ericalapiestral-hash/A1/archive/README.md

# 이전 구성의 참고 코드

A_board_temp_test는 수온 센서를 포함했던 이전 구성의 진단 코드입니다. 현재 기본 A/B 펌웨어와 앱에서는 수온 센서를 사용하지 않습니다. 이 코드를 현재 보드에 업로드하는 안내는 아닙니다.
