ericalapiestral-hash/A1/docs/A_board_fritzing.png

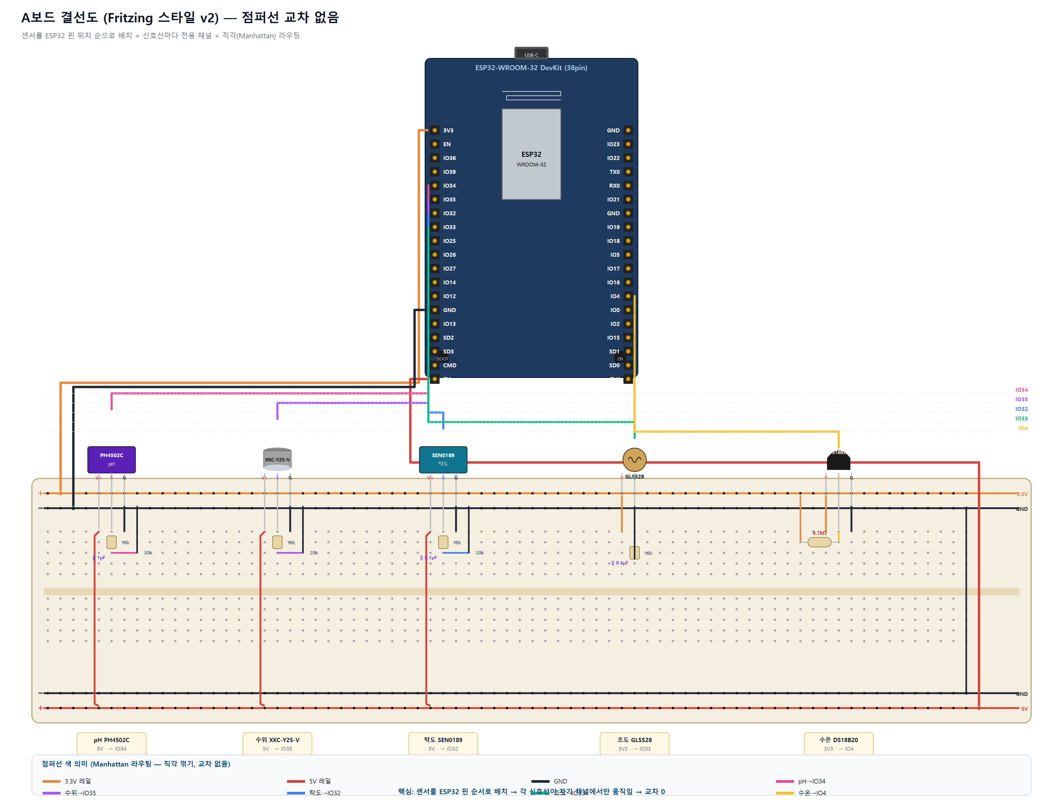
docs/A_board_fritzing.png
