ericalapiestral-hash/A1/docs/app_mockup.png

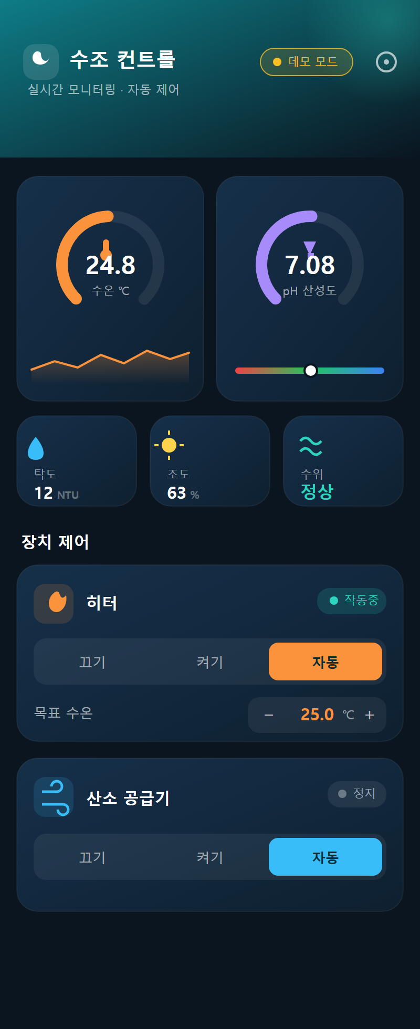
docs/app_mockup.png
