ericalapiestral-hash/A1/docs/B_board_fritzing.png

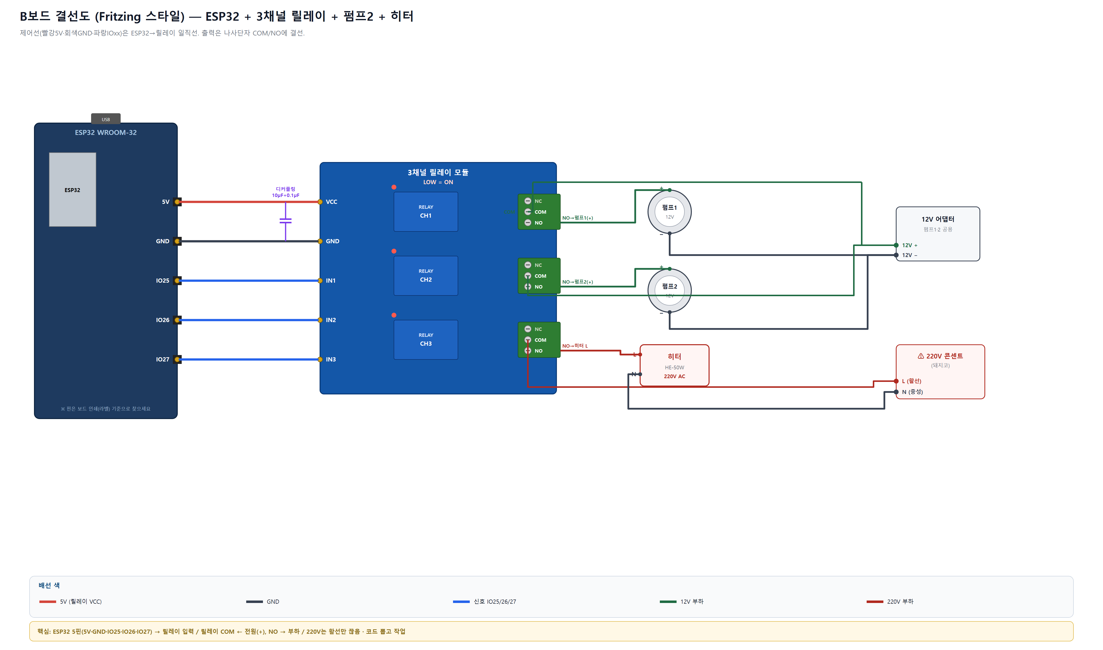
docs/B_board_fritzing.png
