ericalapiestral-hash/A1/docs/explainer_2026-10-15/images/01_system_overview.png

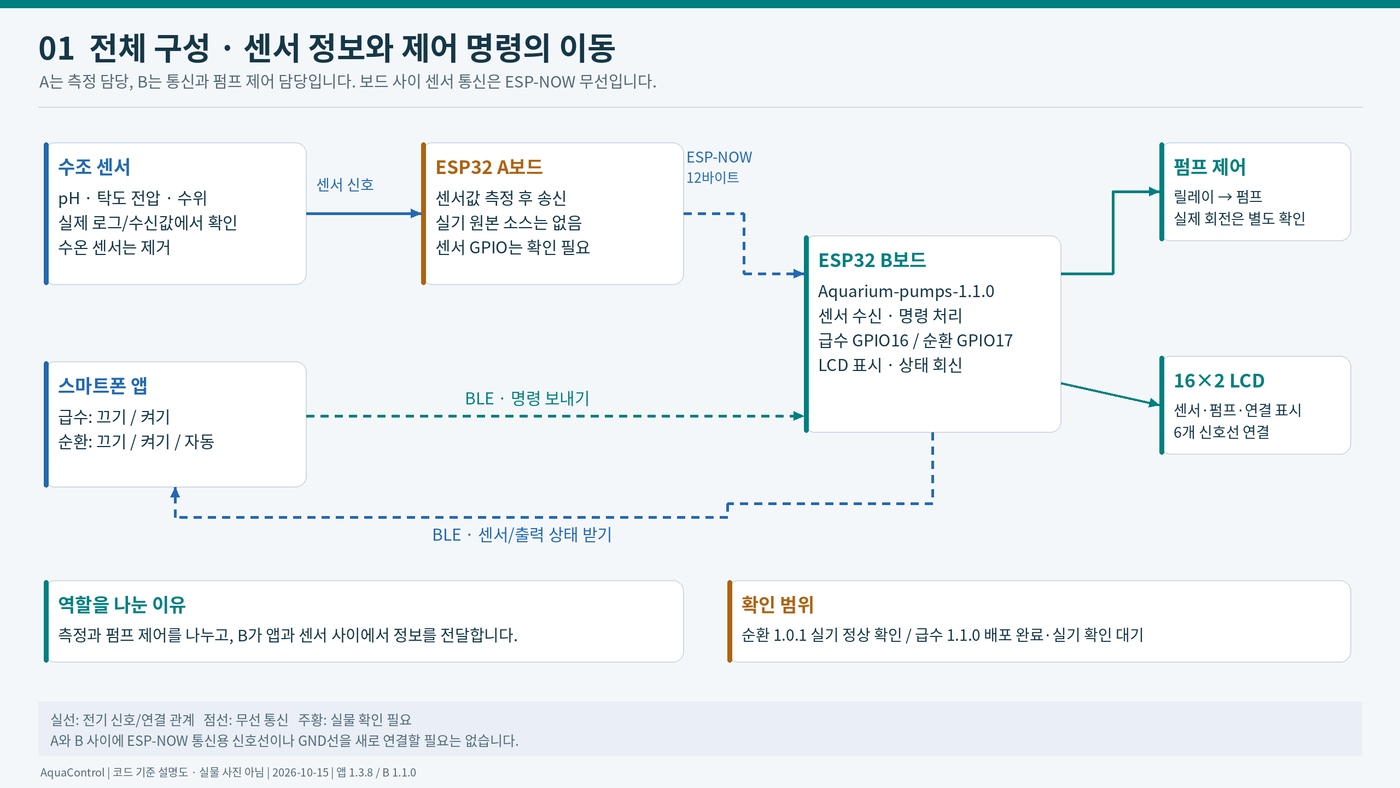
docs/explainer_2026-10-15/images/01_system_overview.png
