ericalapiestral-hash/A1/docs/explainer_2026-10-15/images/02_current_sensors.png

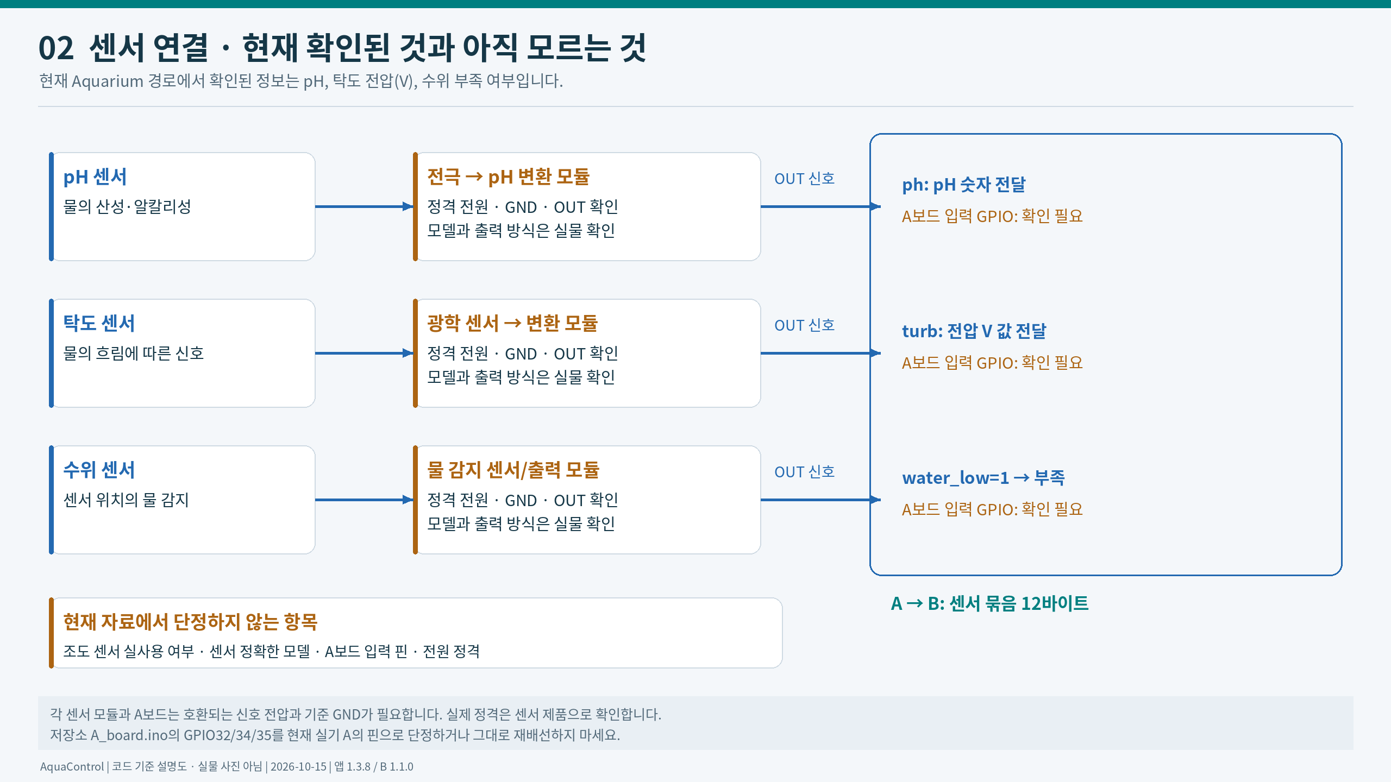
docs/explainer_2026-10-15/images/02_current_sensors.png
