ericalapiestral-hash/A1/docs/explainer_2026-10-15/images/03_b_board_connections.png

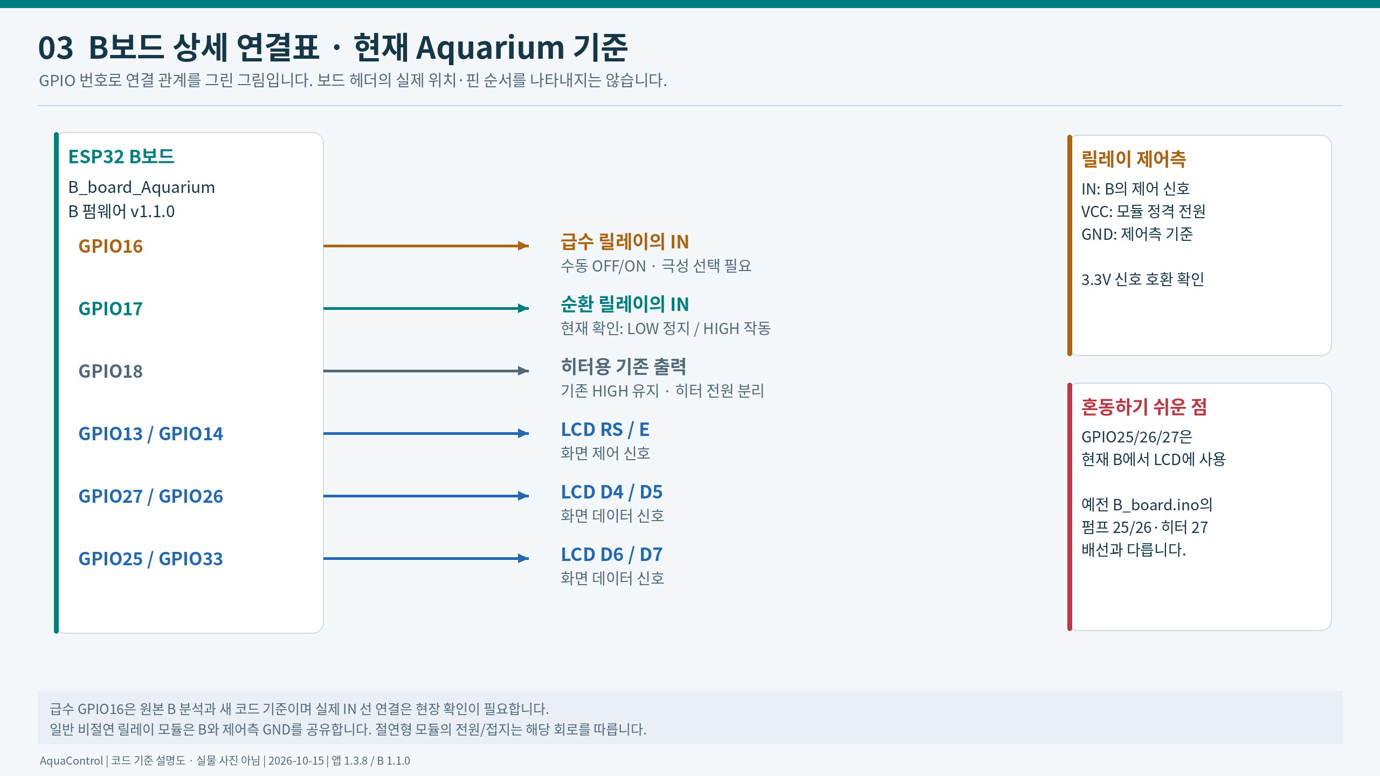
docs/explainer_2026-10-15/images/03_b_board_connections.png
