ericalapiestral-hash/A1/docs/explainer_2026-10-15/images/05_relay_and_dc_pump.png

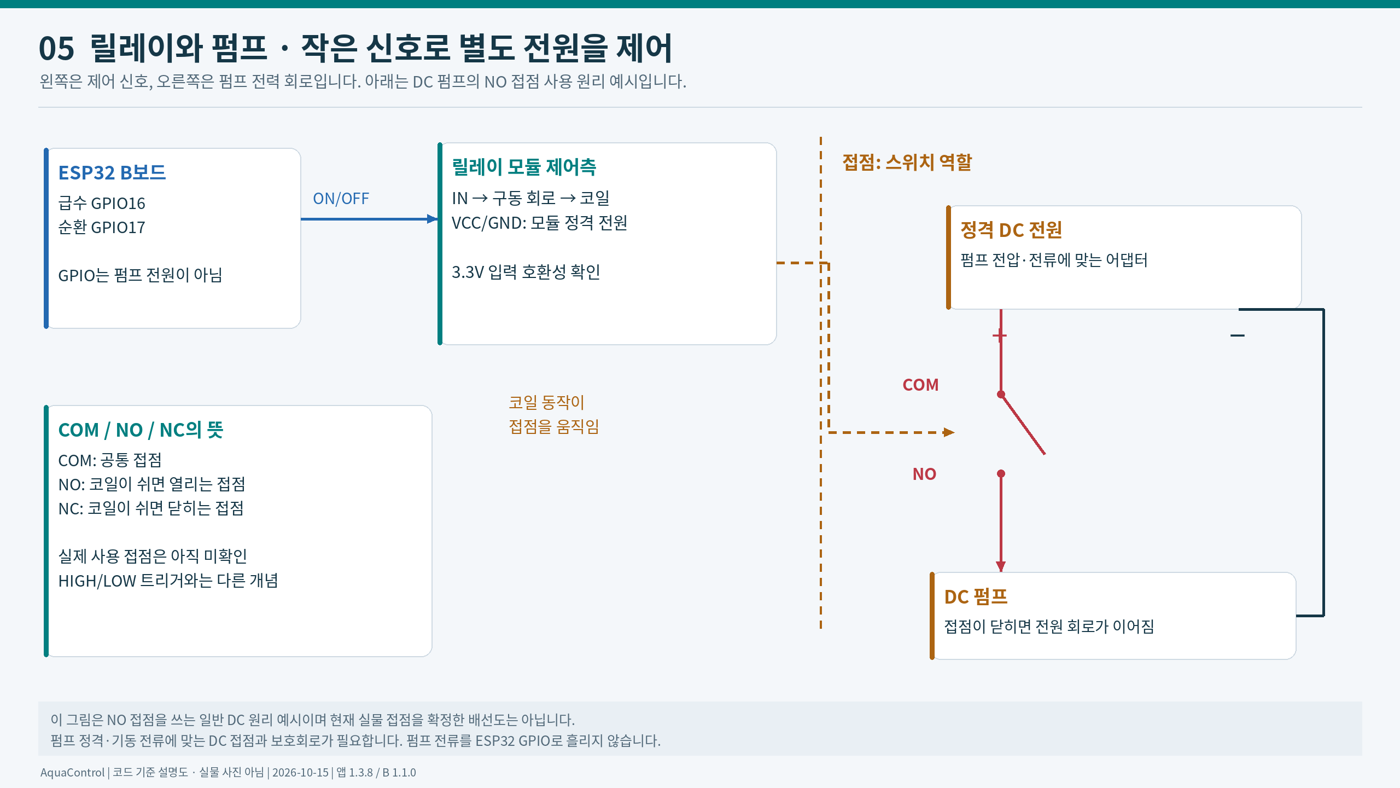
docs/explainer_2026-10-15/images/05_relay_and_dc_pump.png
