ericalapiestral-hash/A1/docs/explainer_2026-10-15/images/06_power_domains.png

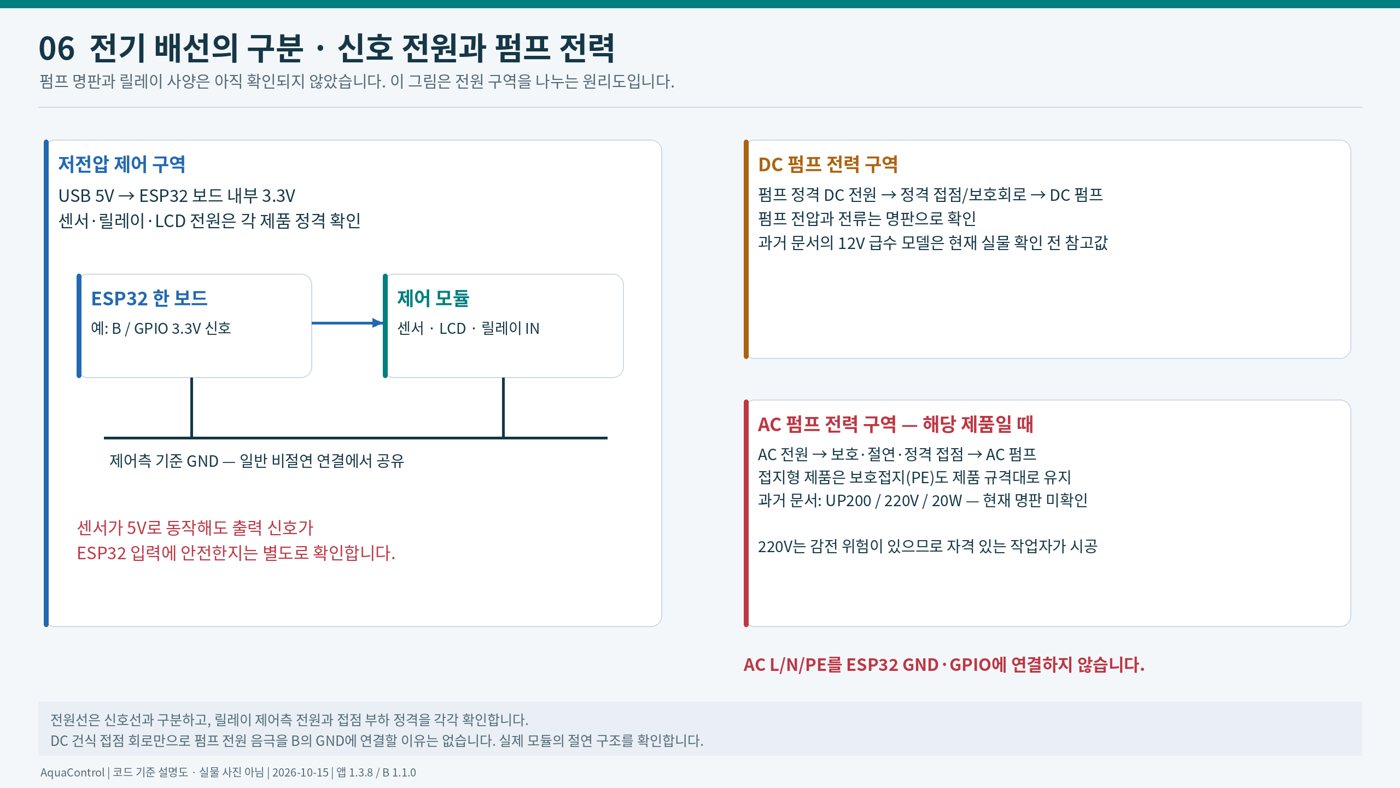
docs/explainer_2026-10-15/images/06_power_domains.png
