ericalapiestral-hash/A1/docs/explainer_2026-10-15/images/07_sensor_signal_principles.png

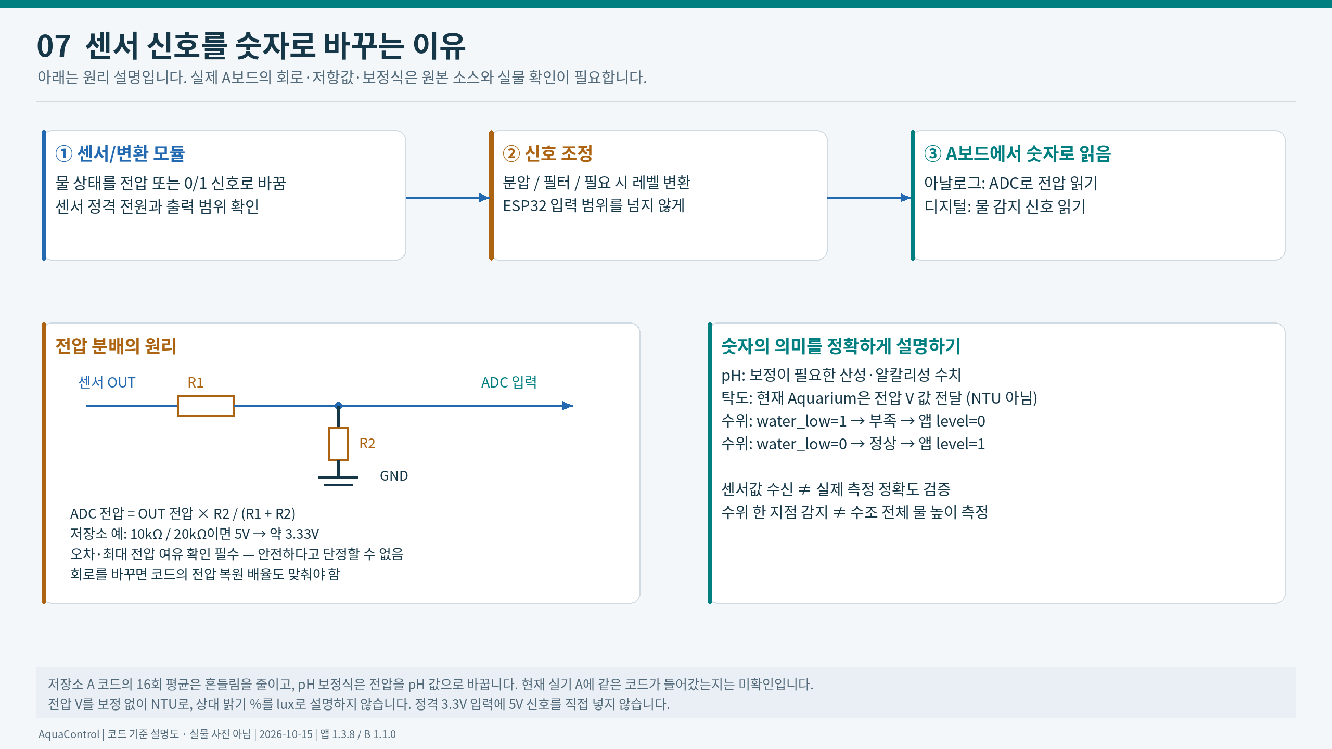
docs/explainer_2026-10-15/images/07_sensor_signal_principles.png
