ericalapiestral-hash/A1/docs/explainer_2026-10-15/images/08_control_and_timing.png

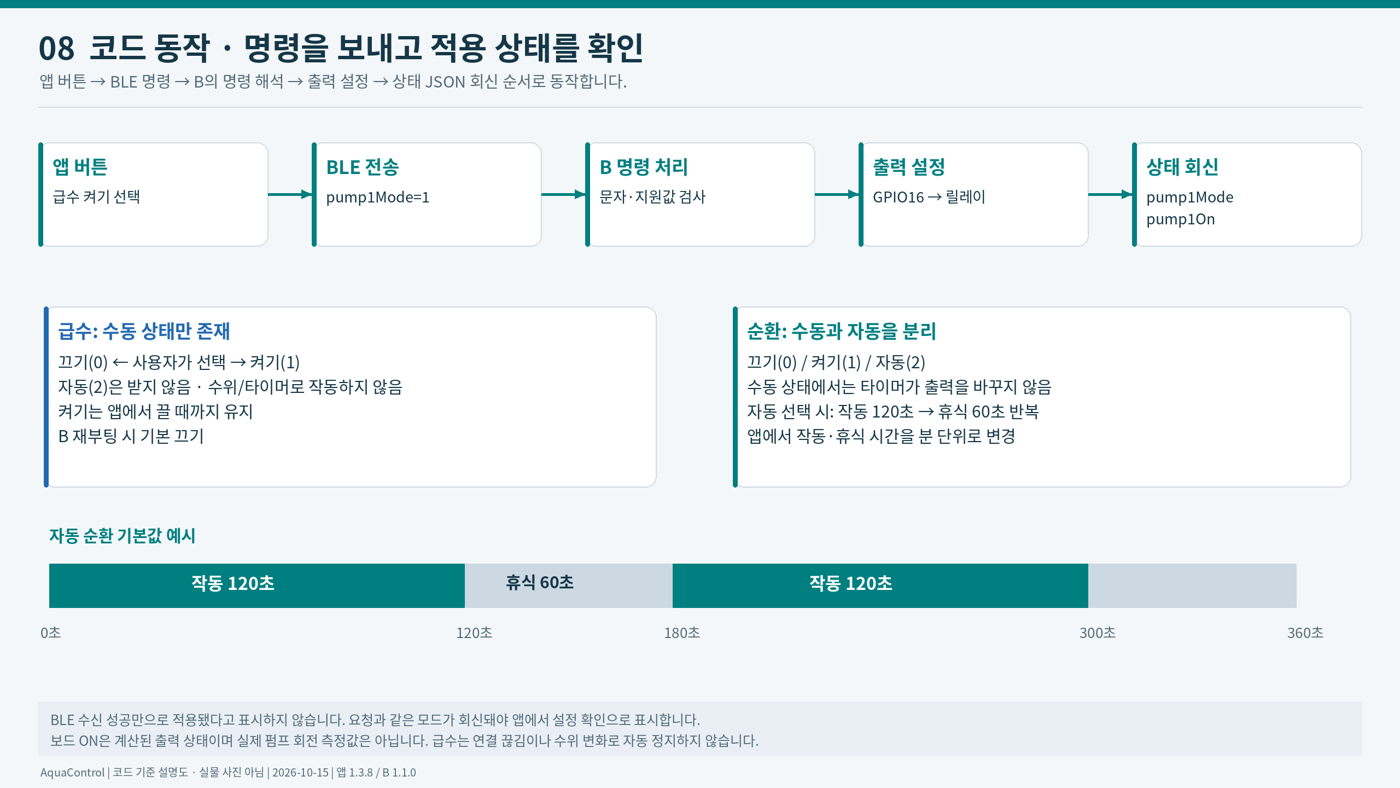
docs/explainer_2026-10-15/images/08_control_and_timing.png
