ericalapiestral-hash/A1/docs/A_board_wiring_v3.png

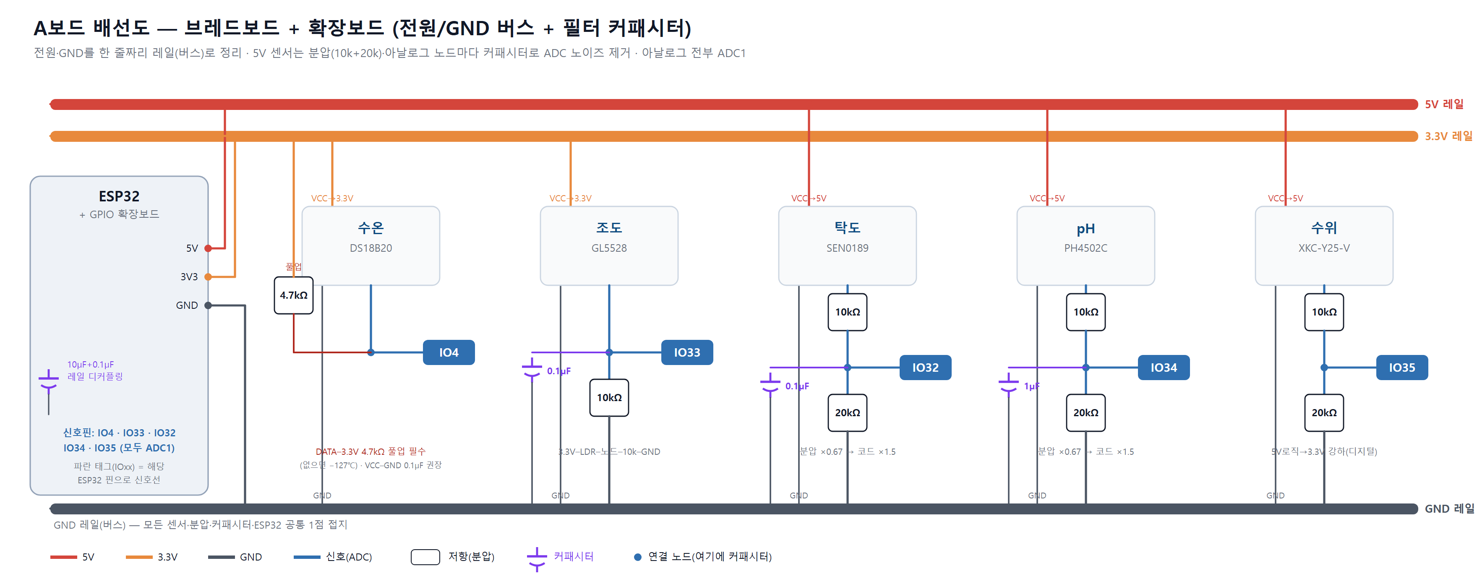
docs/A_board_wiring_v3.png
