ericalapiestral-hash/A1/docs/B_board_wiring_v3.png

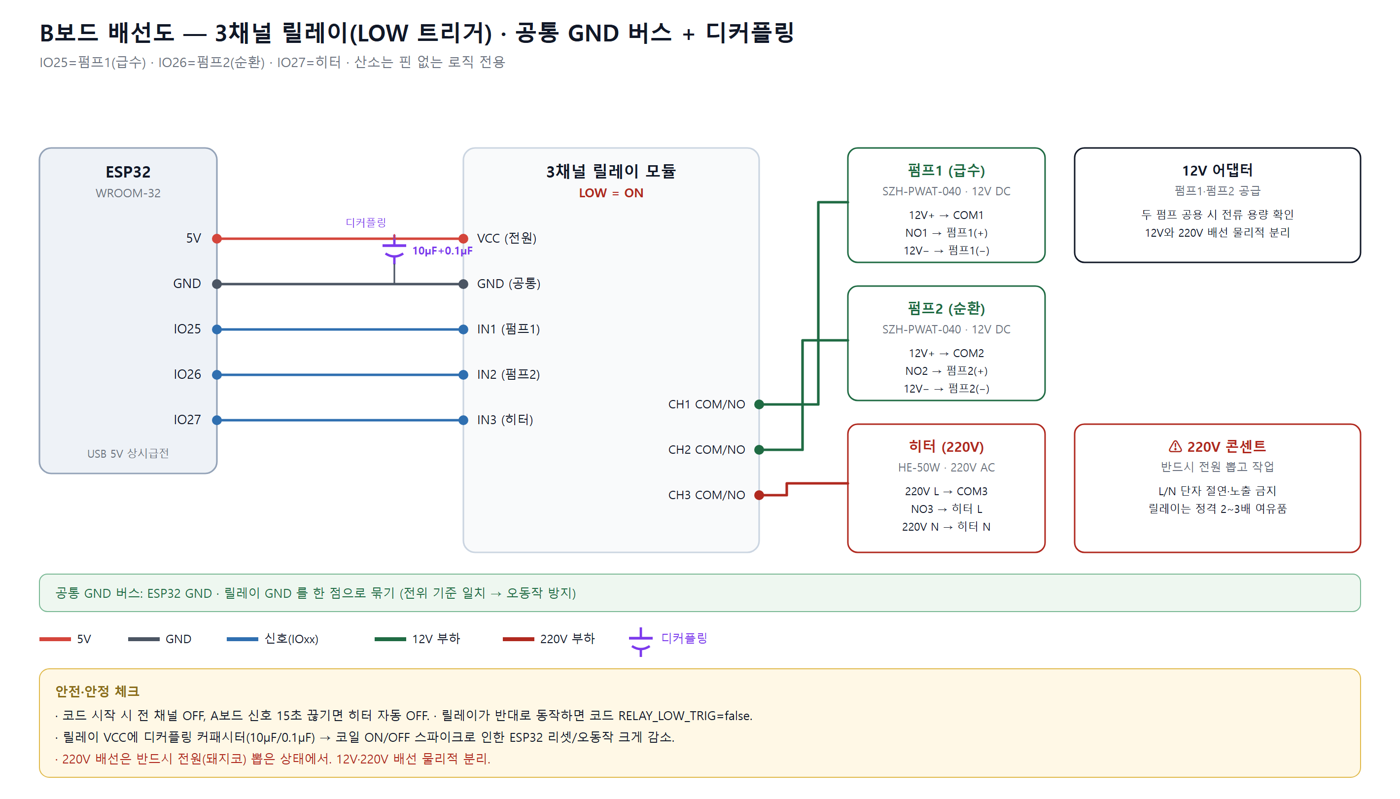
docs/B_board_wiring_v3.png
