ericalapiestral-hash/A1/docs/decoupling_cap_howto.png

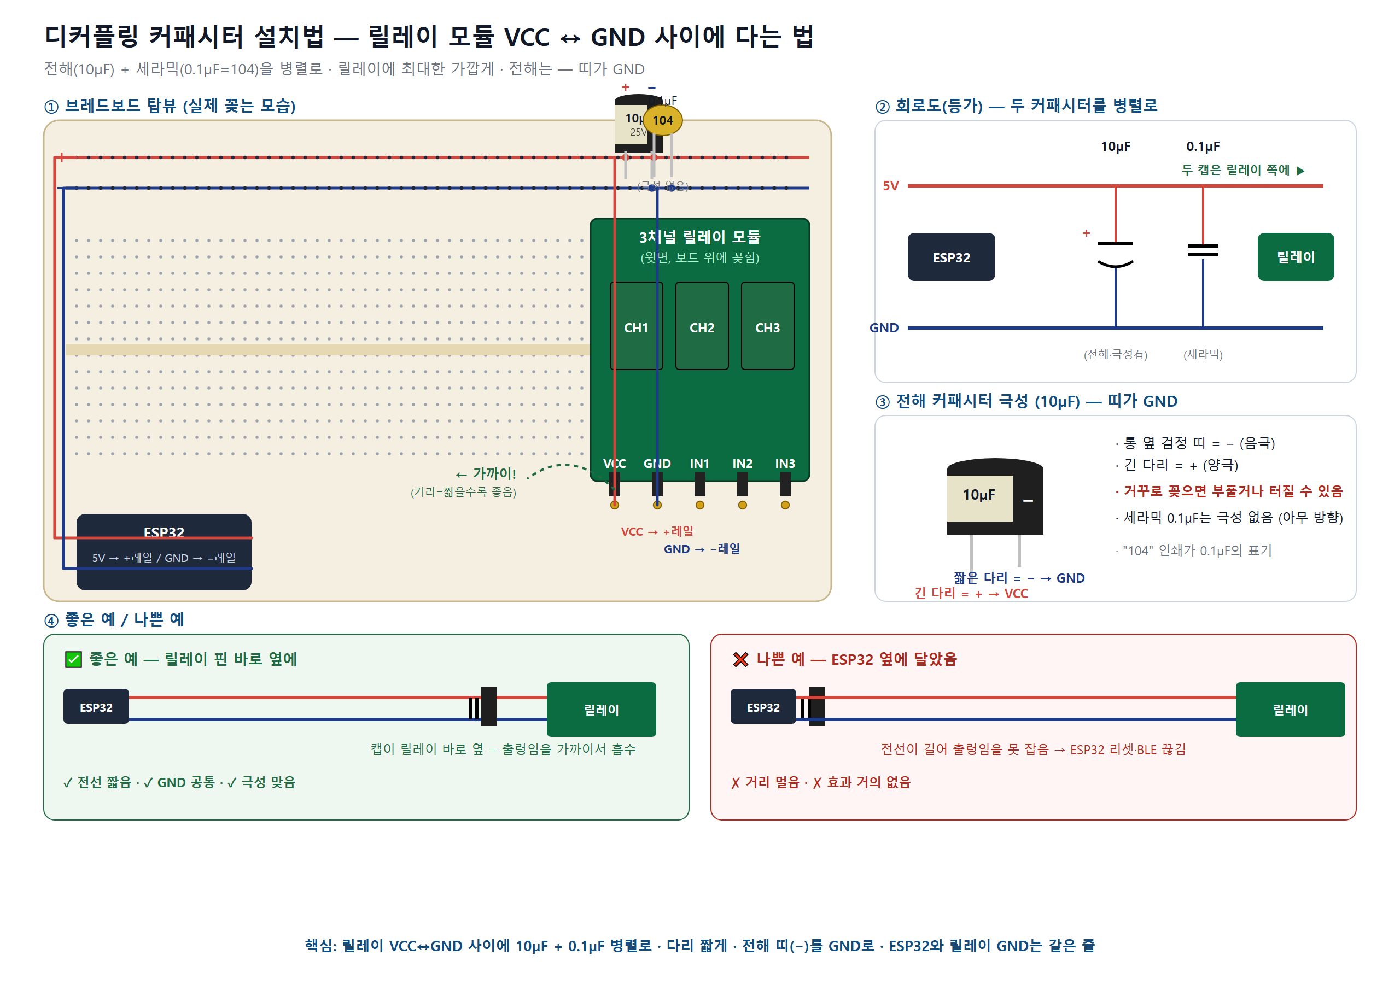
docs/decoupling_cap_howto.png
