ericalapiestral-hash/A1/docs/explainer_2026-10-15/images/04_lcd_wiring.png

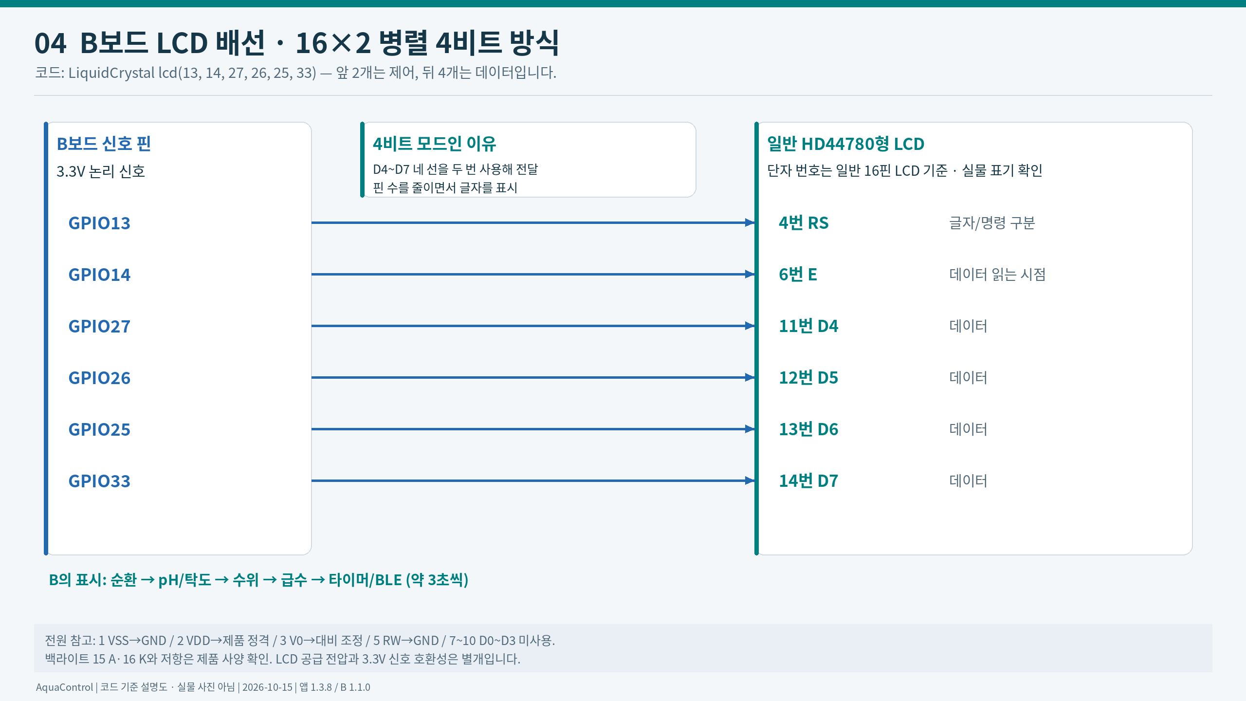
docs/explainer_2026-10-15/images/04_lcd_wiring.png
