ericalapiestral-hash/A1/docs/LCD_wiring.png

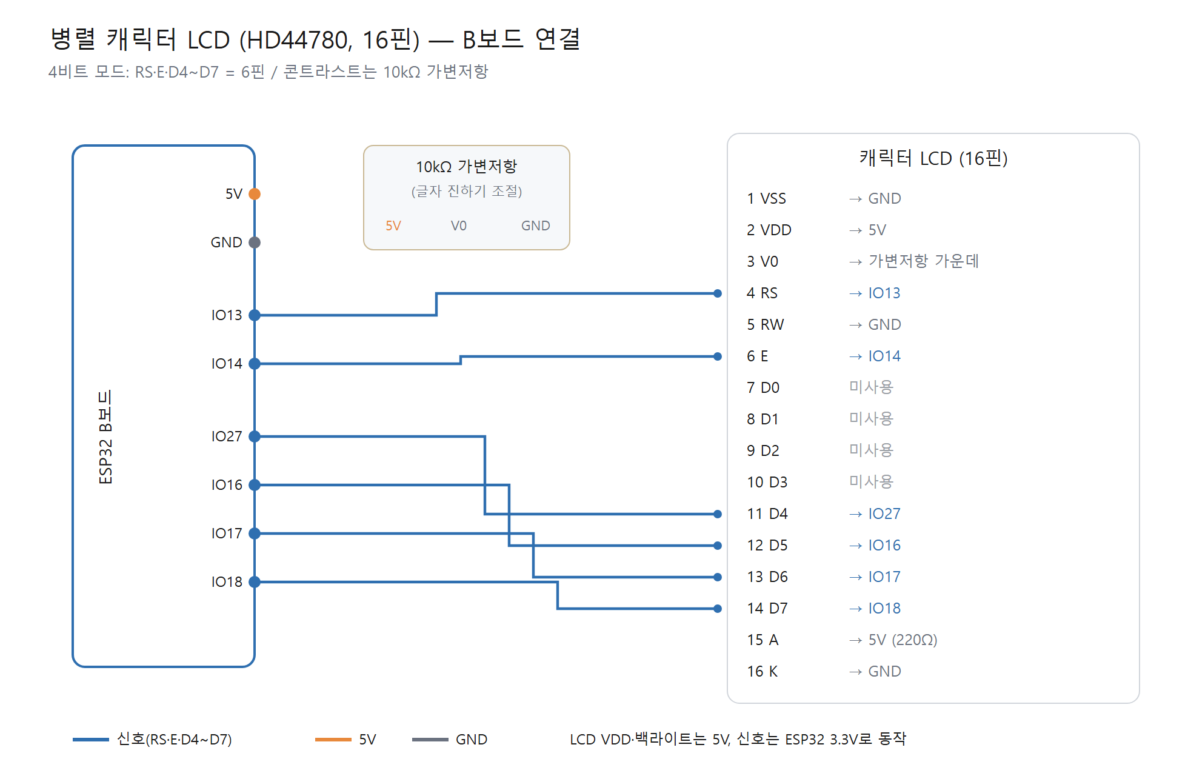
docs/LCD_wiring.png
