ericalapiestral-hash/A1/docs/pump_diode_howto.png

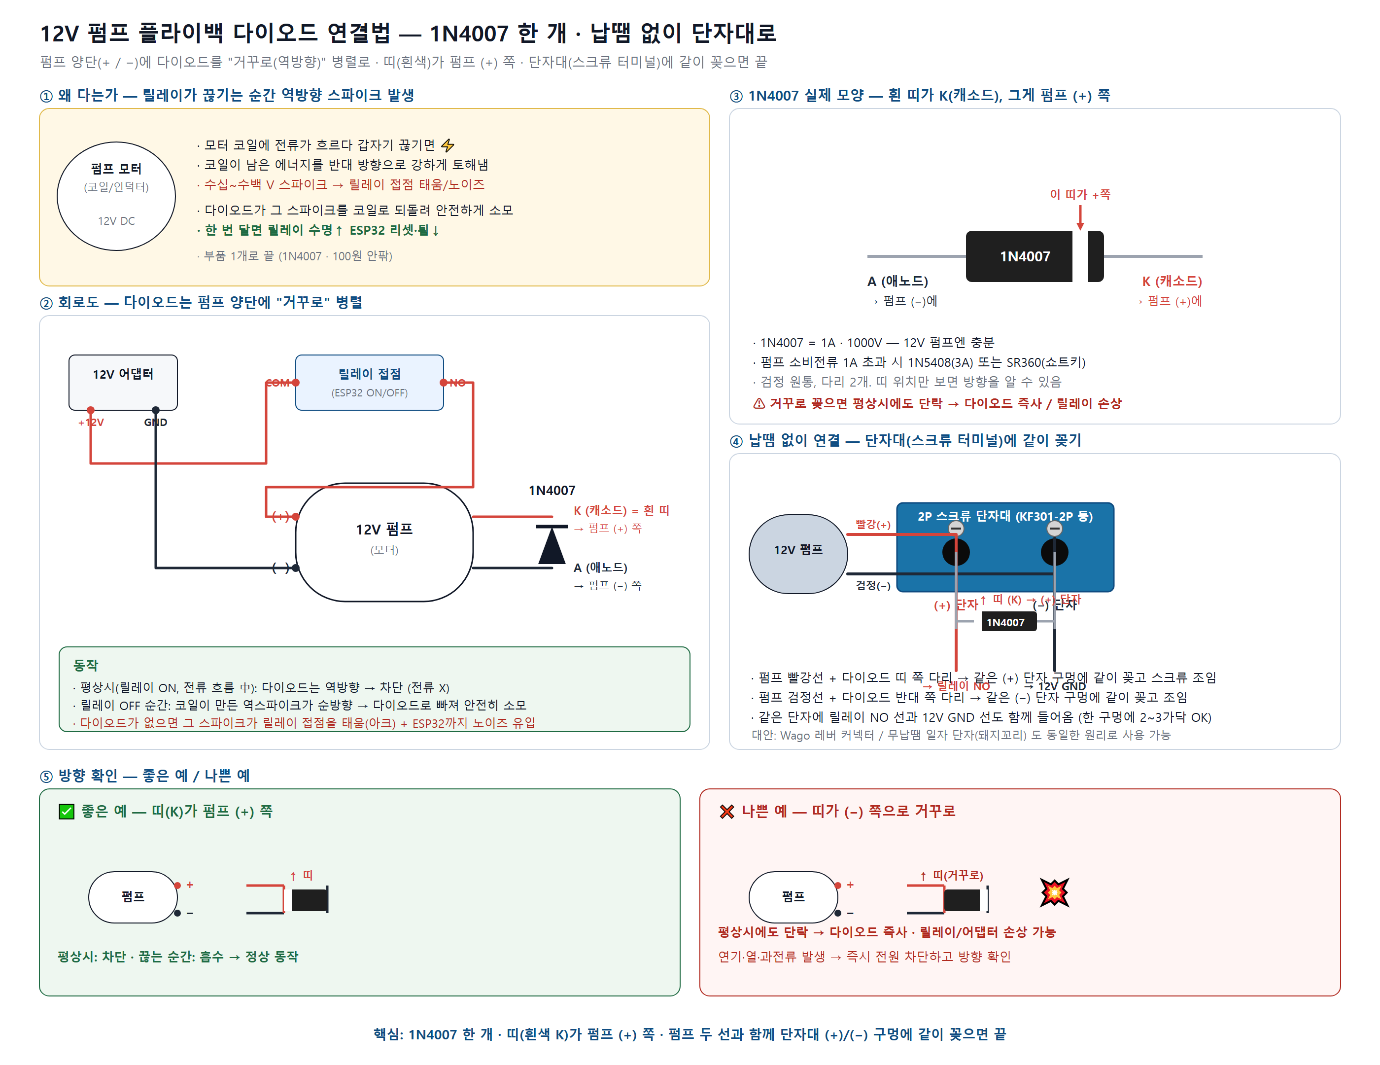
docs/pump_diode_howto.png
