ericalapiestral-hash/A1/docs/pump_wiring_12v_each.png

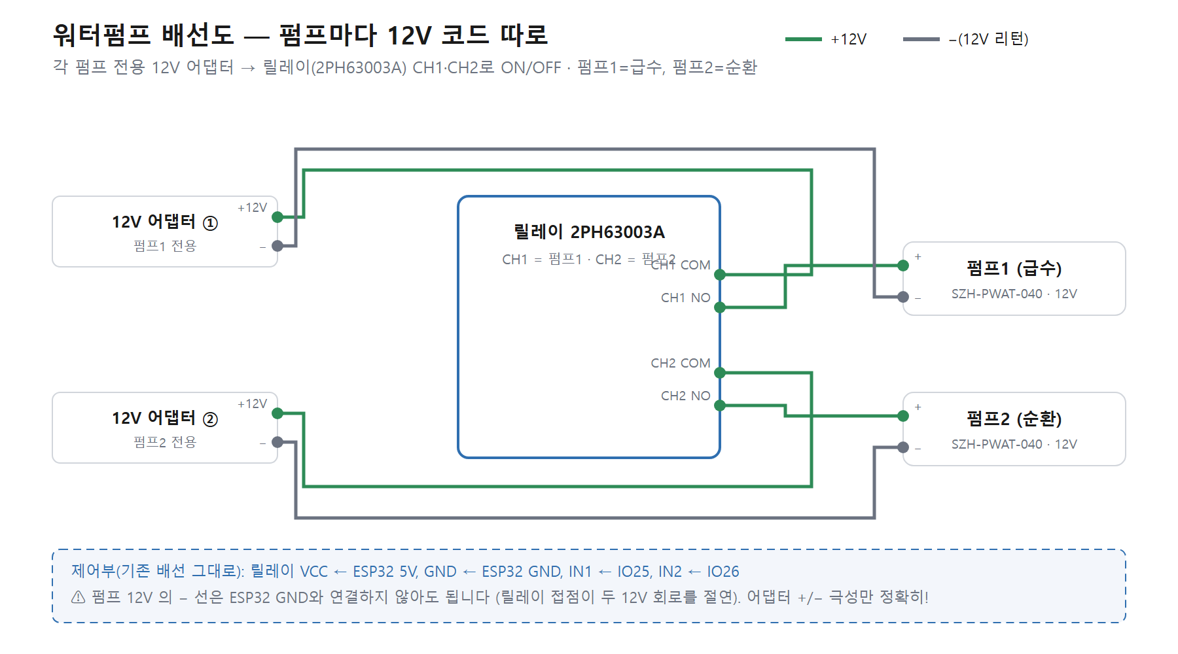
docs/pump_wiring_12v_each.png
