ericalapiestral-hash/A1/docs/UP200_circulation_wiring.png

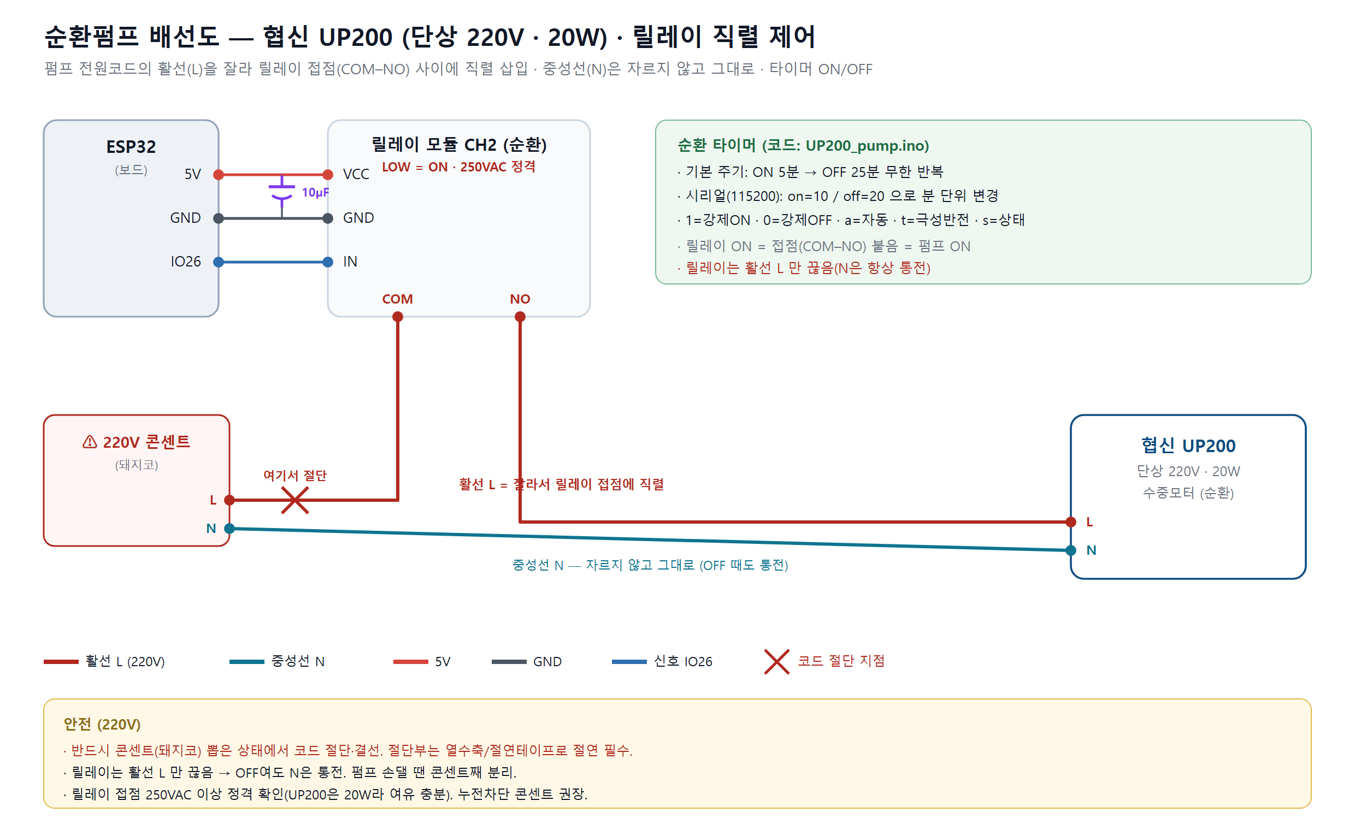
docs/UP200_circulation_wiring.png
