ericalapiestral-hash/A1/(commit log)

2026-08-24 초기 커밋: ESP32 수조 모니터링·제어 시스템
    A보드(센서+LCD) ─ESP-NOW─ B보드(릴레이 제어+BLE) ─BLE─ 안드로이드 앱.
    이번 작업으로 함께 반영한 내용:
    - A_board.ino 컴파일 오류 수정
    getTempCByIndex(0) 뒤에 붙어 있던 오타 'E' 제거.
    - 앱 자동 업데이트 기능 추가 (GitHub Releases)
    lib/updater.dart 릴리스 조회·버전 비교·APK 다운로드(진행률)·설치 실행
    lib/update_ui.dart 업데이트 안내 다이얼로그, 설치 권한 안내
    dashboard.dart 시작 시 자동 확인 + 설정 시트의 '업데이트 확인'
    MainActivity.kt 버전 조회/저장 경로/설치 권한/설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
    [12V_펌프2개_전체결선표.xlsx]
2026-08-24 업데이트 저장소를 ericalapiestral-hash/A1 로 설정
    lib/updater.dart 의 kGithubOwner/kGithubRepo 플레이스홀더를 실제 저장소로
    교체. 이제 앱이 해당 저장소의 Releases 에서 최신 버전을 확인한다.
2026-08-24 GitHub Actions 자동 배포 추가
    태그(v*)를 푸시하면 빌드·서명·릴리스까지 자동으로 처리한다.
    - .github/workflows/release.yml
    버전 확인(태그 != pubspec 이면 실패) -> Flutter 3.44.2 -> Secrets 에서
    키스토어 복원 -> analyze -> APK 빌드 -> 서명 지문 기록 -> 릴리스 생성/첨부.
    Actions 탭에서 수동 실행 시엔 pubspec 버전으로 태그를 만든다.
    - android/app/build.gradle.kts
    android/key.properties 가 있으면 그 릴리스 키로 서명, 없으면 디버그 키로
    폴백하며 경고. 로컬과 CI 가 같은 코드 경로를 쓴다.
    - README 에 키스토어 생성 / Secrets 등록 절차 추가.
    자동 업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
2026-08-24 배포를 로컬 원클릭 스크립트 방식으로 전환
    키스토어/Secrets 설정이 부담돼 GitHub Actions 워크플로를 제거하고,
    이 PC의 디버그 키를 그대로 쓰는 배포 스크립트로 대체한다.
    기존 설치본과 서명이 같아 재설치 없이 자동 업데이트가 이어진다.
    - deploy.ps1 / deploy.cmd 추가
    사용법: .\deploy.cmd 1.2.0 [릴리스 노트]
    버전올림 -> flutter build -> 커밋+태그+푸시 -> gh 릴리스 생성+APK 첨부.
    낮은 버전/중복 태그/빌드 실패는 해당 단계에서 중단.
    - .github/workflows/release.yml 삭제 (Secrets 없이는 태그마다 실패만 남김)
    - build.gradle.kts 의 key.properties 지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
2026-08-24 앱 첫 설치 간편화: QR 코드 + 고정 링크 + USB 설치 스크립트
    - docs/apk_qr.png 폰 카메라로 스캔하면 releases/latest 고정 주소에서
    항상 최신 APK 다운로드 (새 버전이 나와도 QR 재생성 불필요)
    - install.cmd USB 디버깅 켠 폰에 더블클릭으로 설치 (adb install -r)
    - README 에 앱 설치 절 추가, 사용 순서 4번을 그쪽으로 연결
2026-08-24 검증 도구가 남긴 임시 테스트 파일 제거
2026-08-24 좁은 화면에서 게이지 우물이 타원이 되는 문제 수정 (AspectRatio 1:1 고정)
2026-08-24 APK 다운로드 우회용 ZIP 배포 추가
    일부 폰 브라우저(Chrome)가 .apk 직다운로드를 마지막 검사 단계에서
    무한 대기시키는 문제 대응. ZIP 은 일반 파일로 취급돼 끝까지 받아지고
    압축 덕에 크기도 48.8MB -> 23.3MB 로 줄어든다.
    - deploy.ps1: 릴리스에 AquaControl.zip 자동 동봉 (인앱 업데이트는
    .apk 에셋만 쓰므로 영향 없음)
    - docs/apk_zip_qr.png: ZIP 전용 QR (releases/latest 고정 주소)
    - README: ZIP 우회 설치 안내 추가
    - v1.3.0 릴리스에는 ZIP 을 이미 첨부함
2026-10-12 Add a read-only Windows serial capture helper for B-board diagnostics
2026-10-12 Restore control inputs and distinguish BLE writes from board confirmation in v1.3.5
2026-10-14 Add browser board diagnostics and remove temperature sensing in v1.3.6
2026-10-14 Interpret Aquarium ASCII sensor logs in board diagnostics v1.1
2026-10-14 Correct Aquarium circulation display and add verified ESP32 firmware backup tool
2026-10-15 Document Aquarium wiring and code with Korean TXT guides and diagrams
2026-10-15 Add locked manual heater control and GPIO18 relay diagnostics
2026-10-15 Fix relay checker serial startup and add normal reset diagnostics
